iic-jku/iic-audiodac-v1/README.md

# IIC AudioDAC

(c) 2022 Harald Pretl and the class of 336.007 (WS21)

Johannes Kepler University Linz, Institute for Integrated Circuits

Delta-sigma audio DAC (16b, 48kHz), intended for tape-out on MPW-5, SKY130 technology.
