iic-jku/iic-audiodac-v1/(commit log)

2022-02-13 Clean status, dig and ana integrated.
    [audiodac_drv.sch, audiodac_drv_half.sch, audiodac_drv_latch.sch, audiodac_drv_ls.sch, final_summary_report.csv, macro.cfg, pin_order.cfg, tb_audiodac_drv.sch]
2022-02-13 Removed audiodac files (not needed anylonger).
    [final_summary_report.csv, pin_order.cfg]
2022-02-18 Integrated JKU logo.
    [final_summary_report.csv, macro.cfg]
2022-03-07 Ready for TO.
    [final_summary_report.csv, pin_order.cfg]
2022-03-10 Fixed GDS.
    [final_summary_report.csv]
2022-03-11 Fixed LI1 density error.
    [final_summary_report.csv]
2022-03-12 Reduced size of digital macro.
    [final_summary_report.csv, macro.cfg]
2022-03-13 Hopefully final fix for LI1 density.
    [final_summary_report.csv, macro.cfg]
